AlmCoding/sternenhimmel/arduino/README.md

## Arduino Settings
Board: NodeMCU 1.0 ESP-12E Module

## Libraries
MCP23017 by Bertrand Lemasle Version 1.1.2 (https://github.com/blemasle/arduino-mcp23017)
