AlmCoding/sternenhimmel/raspberry-pi/README.txt

Raspberry Pi Access Point
	SSID: Sternenhimmel
	Passwd: Sternenhimmel-psarte
