AlmCoding/sternenhimmel/arduino/esp32-daisy-chain/README.md

# Install Dependencies

The project uses the following libraries:

- ArduinoJson = 7.4.2
- NimBLE-Arduino = 2.3.6
- NimBLEOta = 0.2.0 (https://github.com/h2zero/NimBLEOta)

NimBLEOta must be downloaded from GitHub and added to the Arduino IDE libraries folder via:  
**Sketch => Include Library => Add .ZIP Library ...**
