AlmCoding/sternenhimmel/eagle/versions/v3_esp82_not_produced.odt

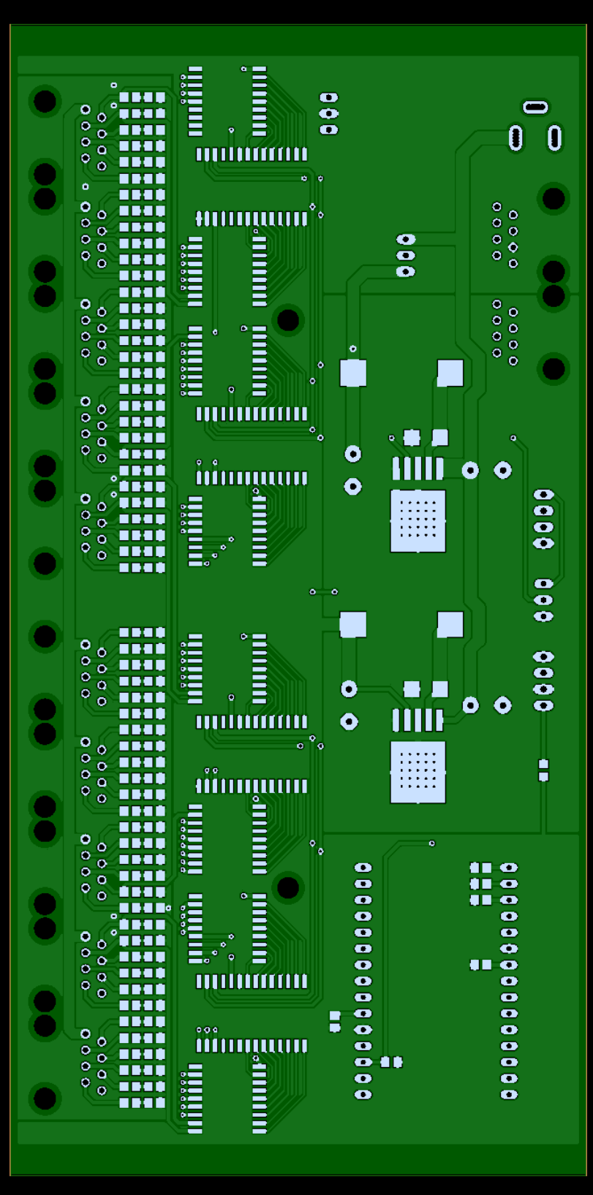
[picture p1: figure]
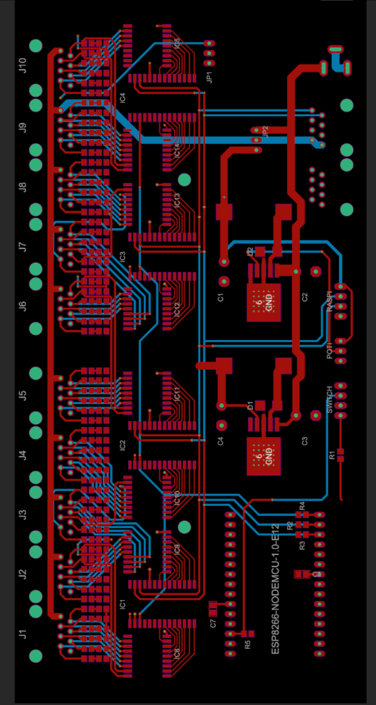
[picture p2: figure]
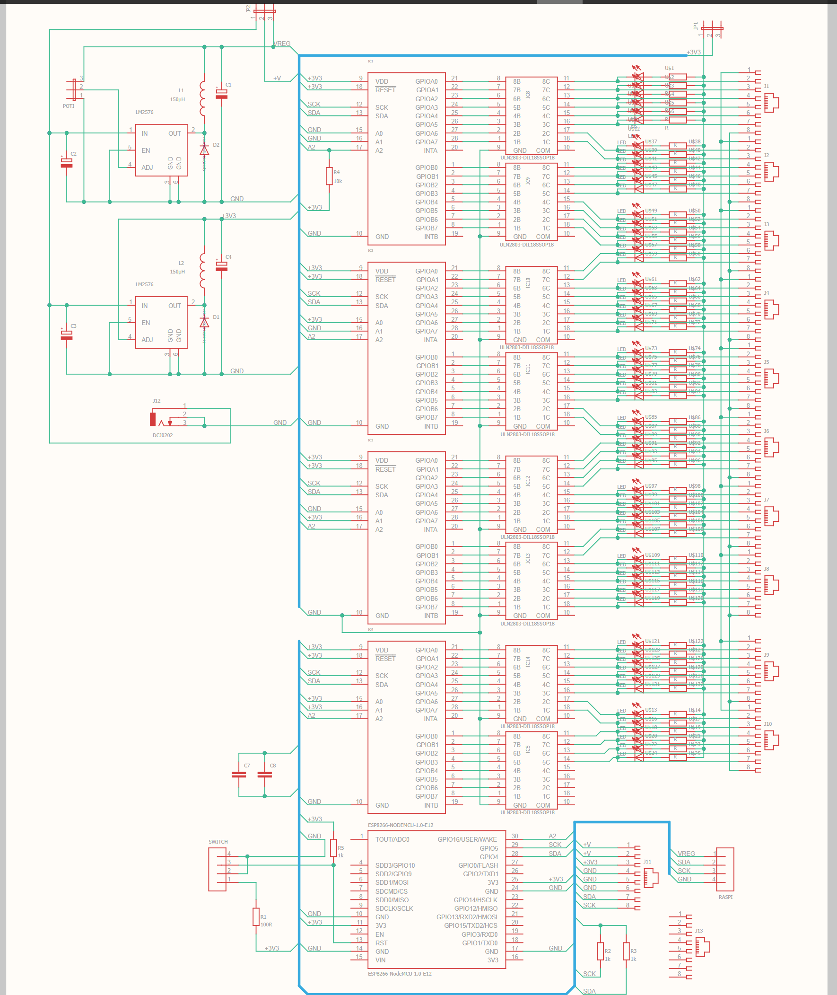
[picture p3: figure]
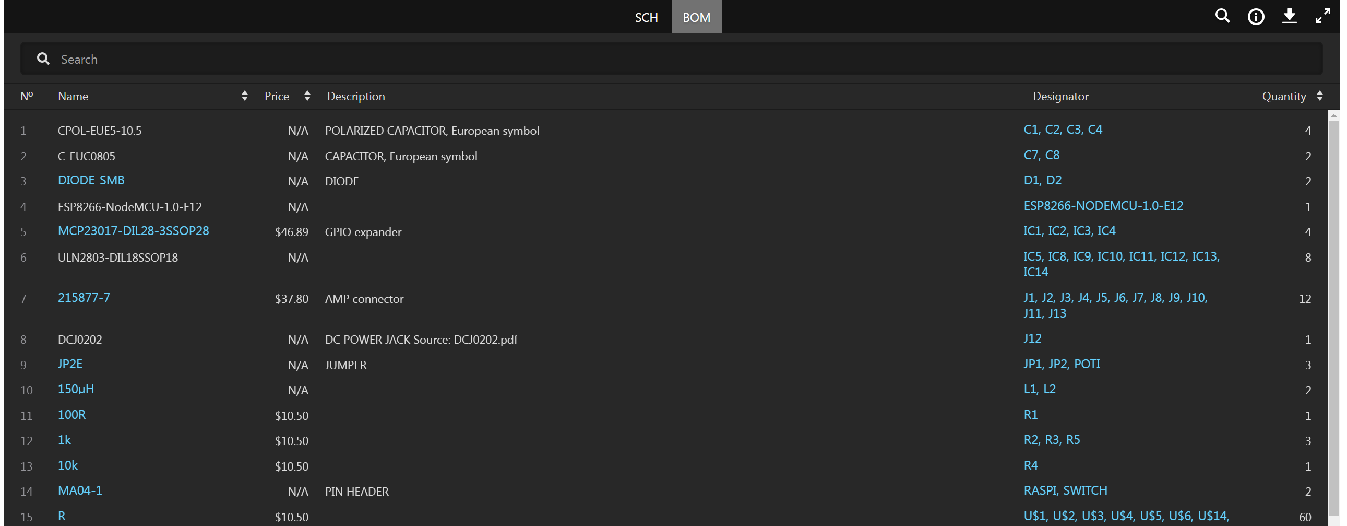
[picture p4: figure]
