AlmCoding/sternenhimmel/kicad/esp32-controller/esp32-controller.ods

Id | Designator | Footprint | Quantity | Designation | Price [€] | Total [€]
1 | C15 | C_0805_2012Metric | 1 | 22uF | 0.20 | 0.20
2 | C7,C8,C1,C9,C2,C17,C16,C3 | C_0805_2012Metric | 8 | 100nF | 0.10 | 0.80
3 | J3,J2,J1,J6,J4,J5 | RJ45_Amphenol_54602-x08_Horizontal | 6 | RJ45 | 0.50 | 3.00
4 | C4,C5,C11,C12,C6,C10 | C_0805_2012Metric | 6 | 4nF | 0.10 | 0.60
5 | U6,U11,U12,U5,U4,U10 | SOT-23-5_HandSoldering | 6 | 74AHC1G08 | 0.15 | 0.90
6 | BOOT1,RESET1 | SW_SPST_Omron_B3FS-100xP | 2 | SW_Omron_B3FS | 0.15 | 0.30
7 | R3 | R_0805_2012Metric | 1 | 330 | 0.10 | 0.10
8 | TP2,TP1 | TestPoint_Pad_D2.0mm | 2 | TestPoint
9 | D1 | LED_0805_2012Metric | 1 | LED | 0.07 | 0.07
10 | U3,U1,U8,U7,U9,U2 | TSSOP-16_4.4x5mm_P0.65mm | 6 | SN65LVDS049 | 1.50 | 9.00
11 | C14 | C_0805_2012Metric | 1 | 10uF | 0.15 | 0.15
12 | U14 | ESP32-S3-WROOM-1 | 1 | ESP32-S3-WROOM-1 | 4.90 | 4.90
13 | R1,R2 | R_0805_2012Metric | 2 | 10k | 0.10 | 0.20
14 | J8 | PinHeader_1x04_P2.54mm_Vertical | 1 | Conn_01x04_Pin | 0.15 | 0.15
15 | TP3 | TestPoint_Pad_D1.5mm | 1 | SCK
16 | TP4 | TestPoint_Pad_D1.5mm | 1 | MOSI
17 | J7 | BarrelJack_Kycon_KLDX-0202-xC_Horizontal | 1 | Barrel_Jack_Switch | 0.45 | 0.45
18 | C13 | C_0805_2012Metric | 1 | 1uF | 0.10 | 0.10
19 | U13 | SOT-223-3_TabPin2 | 1 | AZ1117-3.3 | 0.15 | 0.15
 |  |  |  |  | PCB | 20.00
 |  |  |  |  | SUM (Bauteile+Platine) | 41.07
 |  |  |  |  | “21%” MwSt. | 8.6247
 |  |  |  |  | TOTAL | 49.6947
