AlmCoding/sternenhimmel/kicad/led-driver/led-driver.ods

Id | Designator | Footprint | Quantity | Designation | Price [€] | Total [€]
1 | D3,D11,D5,D2,D13,D8,D1,D7,D4,D9,D10,D6,D12 | LED_0805_2012Metric | 13 | LED | 0.07 | 0.91
2 | C3,C4 | C_0805_2012Metric | 2 | 100nF | 0.08 | 0.16
3 | J2,J1 | RJ45_Amphenol_54602-x08_Horizontal | 2 | RJ45 | 0.50 | 1.00
4 | C5 | C_0805_2012Metric | 1 | 4nF | 0.10 | 0.10
5 | J3 | PinSocket_1x02_P2.54mm_Vertical | 1 | Conn_01x02_Pin | 0.10 | 0.10
6 | J11,J5,J7,J6,J4,J8,J10,J9 | PinHeader_2x06_P2.54mm_Vertical | 8 | Conn_02x06_Odd_Even | 0.15 | 1.20
7 | R1,R2 | R_0805_2012Metric | 2 | 100 | 0.10 | 0.20
8 | C1 | C_0805_2012Metric | 1 | 1uF | 0.10 | 0.10
9 | C2 | C_0805_2012Metric | 1 | 10uF | 0.15 | 0.15
10 | R3 | R_0805_2012Metric | 1 | 2k4 | 0.10 | 0.10
11 | U1 | SOT-23-5 | 1 | LP2985-33DBVR | 0.25 | 0.25
12 | U3 | HTSSOP-20-1EP_4.4x6.5mm_P0.65mm_EP3.4x6.5mm_Mask2.75x3.43mm_ThermalVias | 1 | TLC5971PWP | 1.90 | 1.90
13 | U2 | TSSOP-16_4.4x5mm_P0.65mm | 1 | SN65LVDS049 | 1.50 | 1.50
14 | R5 | R_0805_2012Metric | 1 | 2k | 0.10 | 0.10
15 | R4 | R_0805_2012Metric | 1 | 0
 |  |  |  |  |  |  | 4.50 | https://be.eurocircuits.com/
 |  |  |  |  | PCB | 3.00 | 2.00 | https://portal.multi-circuit-boards.eu/
 |  |  |  |  | SUM (Bauteile+Platine) | 10.77
 |  |  |  |  | “21%” MwSt. | 2.2617
 |  |  |  | 60 | Pieces | 646.20
 |  |  |  |  | “21%” | 135.702
 |  |  |  |  | TOTAL | 781.90
 |  |  |  | *Bauteilpreise beinhalten Rabatte von Bestellmengen für ~2 Sternenhimmel
