AlmCoding/sternenhimmel/eagle/versions/v2_esp82.pdf

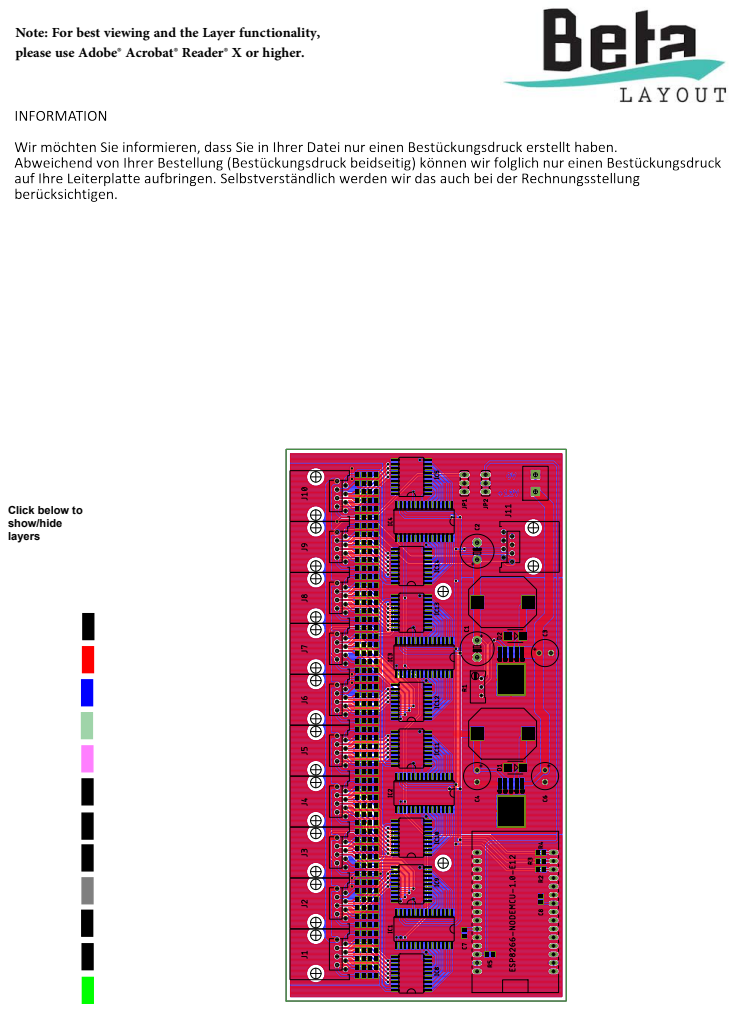
[picture p5: page 1]

Note: For best viewing and the Layer functionality,
please use Adobe® Acrobat® Reader® X or higher.
