AlmCoding/sternenhimmel/eagle/versions/v1_esp82.pdf

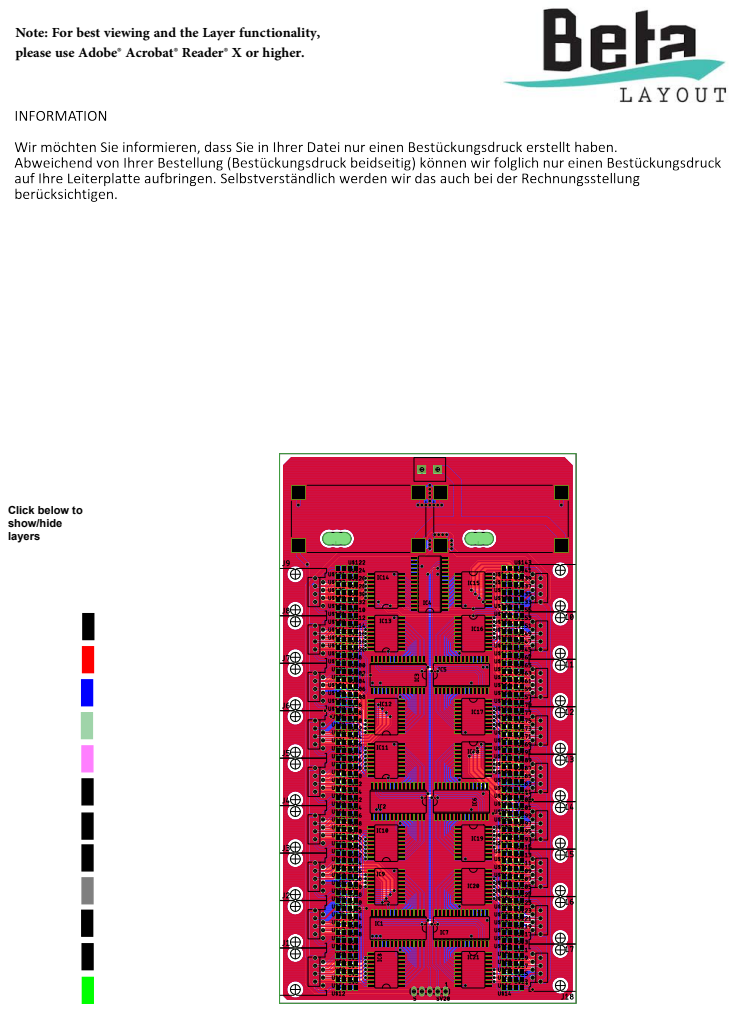
[picture p6: page 1]

Note: For best viewing and the Layer functionality,
please use Adobe® Acrobat® Reader® X or higher.
