AlmCoding/sternenhimmel/kicad/led-driver/led-driver.kicad_pcb

## KiCad design kicad/led-driver/led-driver.kicad_pcb (2025-09-02)

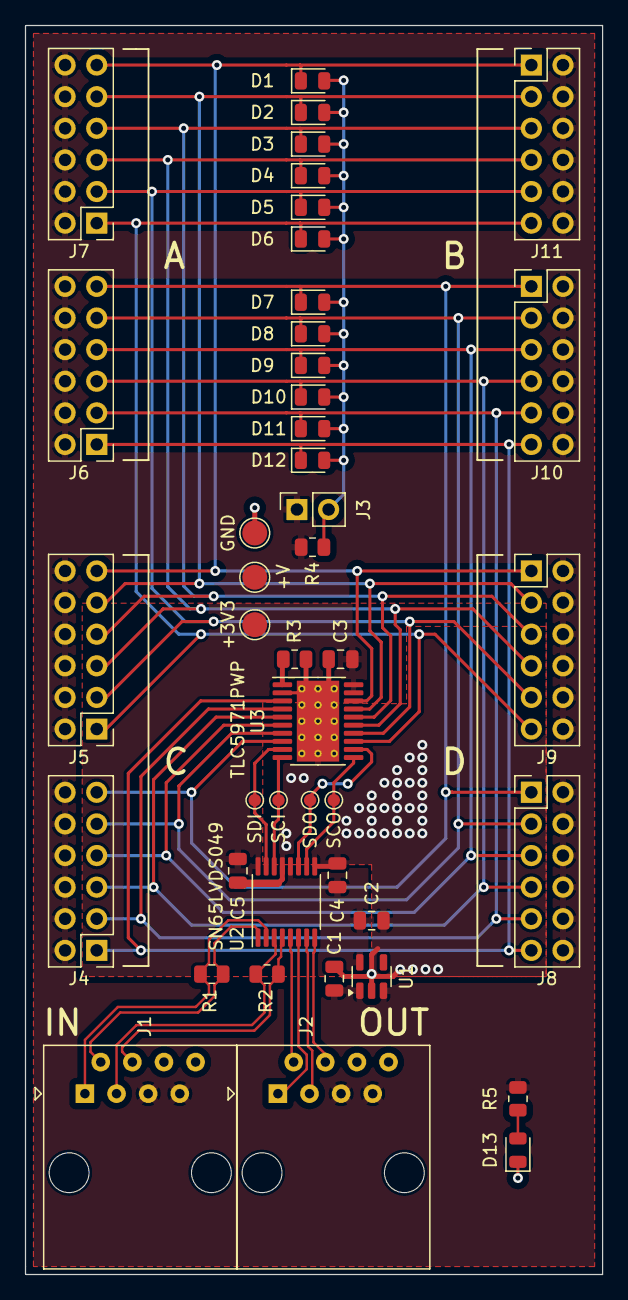
[picture p7: board led-driver.kicad_pcb from above]

Board: 2 copper layers, 46.4 x 100.3 mm, 44 parts (0 on the bottom side), 30 nets.

Parts:
+3V3: TestPoint_Pad_D2.0mm
+V: TestPoint_Pad_D2.0mm
C1: 1uF; C_0805_2012Metric
C2: 10uF; C_0805_2012Metric
C3, C4: 100nF; C_0805_2012Metric
C5: 4nF; C_0805_2012Metric
D1, D2, D3, D4, D5, D6, D7, D8, D9, D10, D11, D12, D13: LED; LED_0805_2012Metric
GND: TestPoint_Pad_D2.0mm
J1, J2: RJ45; RJ45_Amphenol_54602-x08_Horizontal
J3: Conn_01x02_Pin; PinSocket_1x02_P2.54mm_Vertical
J4, J5, J6, J7, J8, J9, J10, J11: Conn_02x06_Odd_Even; PinHeader_2x06_P2.54mm_Vertical
R1, R2: 100; R_0805_2012Metric
R3: 2k4; R_0805_2012Metric
R4: 0; R_0805_2012Metric
R5: 2k; R_0805_2012Metric
SCI: TestPoint_Pad_D1.0mm
SCO: TestPoint_Pad_D1.0mm
SDI: TestPoint_Pad_D1.0mm
SDO: TestPoint_Pad_D1.0mm
U1: LP2985-33DBVR; SOT-23-5
U2: SN65LVDS049; TSSOP-16_4.4x5mm_P0.65mm
U3: TLC5971PWP; HTSSOP-20-1EP_4.4x6.5mm_P0.65mm_EP3.4x6.5mm_Mask2.75x3.43mm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

Connections:
+3V3: +3V3.1, C2.1, C3.1, C4.1, C5.1, U1.5 (VOUT), U2.12 (VCC), U2.16 (EN), U3.19 (VCC), U3.20 (VREG)
+12V: +V.1, C1.1, J1.5, J1.7, J2.5, J2.7, J3.1, J4.2, J4.4, J4.6, J4.8, J4.10, J4.12, J5.2, J5.4, J5.6, J5.8, J5.10, J5.12, J6.2, J6.4, J6.6, J6.8, J6.10, J6.12, J7.2, J7.4, J7.6, J7.8, J7.10, J7.12, J8.2, J8.4, J8.6, J8.8, J8.10, J8.12, J9.2, J9.4, J9.6, J9.8, J9.10, J9.12, J10.2, J10.4, J10.6, J10.8, J10.10, J10.12, J11.2, J11.4, J11.6, J11.8, J11.10, J11.12, R4.2, R5.1, U1.1 (VIN), U1.3 (EN)
/Cin_N: J1.3, R2.2, U2.3 (RIN2-)
/Cin_P: J1.4, R2.1, U2.4 (RIN2+)
/Cout_N: J2.3, U2.7 (DOUT1-)
/Cout_P: J2.4, U2.8 (DOUT1+)
/Din_N: J1.2, R1.2, U2.1 (RIN1-)
/Din_P: J1.1, R1.1, U2.2 (RIN1+)
/Dout_N: J2.2, U2.5 (DOUT2-)
/Dout_P: J2.1, U2.6 (DOUT2+)
GND: C1.2, C2.2, C3.2, C4.2, C5.2, D13.1 (K), GND.1, J1.6, J1.8, J2.6, J2.8, R3.2, U1.2 (GND), U2.9 (~EN), U2.13 (GND), U3.2 (GND), U3.21 (GND)
unnamed: D1.2 (A), D2.2 (A), D3.2 (A), D4.2 (A), D5.2 (A), D6.2 (A), D7.2 (A), D8.2 (A), D9.2 (A), D10.2 (A), D11.2 (A), D12.2 (A), J3.2, R4.1
unnamed: D1.1 (K), J5.11, J7.11, J9.1, J11.1, U3.18 (OUTB3)
unnamed: D2.1 (K), J5.9, J7.9, J9.3, J11.3, U3.17 (OUTG3)
unnamed: D3.1 (K), J5.7, J7.7, J9.5, J11.5, U3.16 (OUTR3)
unnamed: D4.1 (K), J5.5, J7.5, J9.7, J11.7, U3.15 (OUTB2)
unnamed: D5.1 (K), J5.3, J7.3, J9.9, J11.9, U3.14 (OUTG2)
unnamed: D6.1 (K), J5.1, J7.1, J9.11, J11.11, U3.13 (OUTR2)
unnamed: D7.1 (K), J4.11, J6.11, J8.1, J10.1, U3.8 (OUTB1)
unnamed: D8.1 (K), J4.9, J6.9, J8.3, J10.3, U3.7 (OUTG1)
unnamed: D9.1 (K), J4.7, J6.7, J8.5, J10.5, U3.6 (OUTR1)
unnamed: D10.1 (K), J4.5, J6.5, J8.7, J10.7, U3.5 (OUTB0)
unnamed: D11.1 (K), J4.3, J6.3, J8.9, J10.9, U3.4 (OUTG0)
unnamed: D12.1 (K), J4.1, J6.1, J8.11, J10.11, U3.3 (OUTR0)
unnamed: D13.2 (A), R5.2
unnamed: SCO.1, U2.10 (DIN1), U3.11 (SCKO)
unnamed: SDO.1, U2.11 (DIN2), U3.12 (SDTO)
unnamed: SDI.1, U2.15 (ROUT1), U3.9 (SDTI)
unnamed: SCI.1, U2.14 (ROUT2), U3.10 (SCKI)
unnamed: R3.1, U3.1 (IREF)
