AlmCoding/sternenhimmel/kicad/esp32-controller/esp32-controller.kicad_pcb

## KiCad design kicad/esp32-controller/esp32-controller.kicad_pcb (2025-08-04)

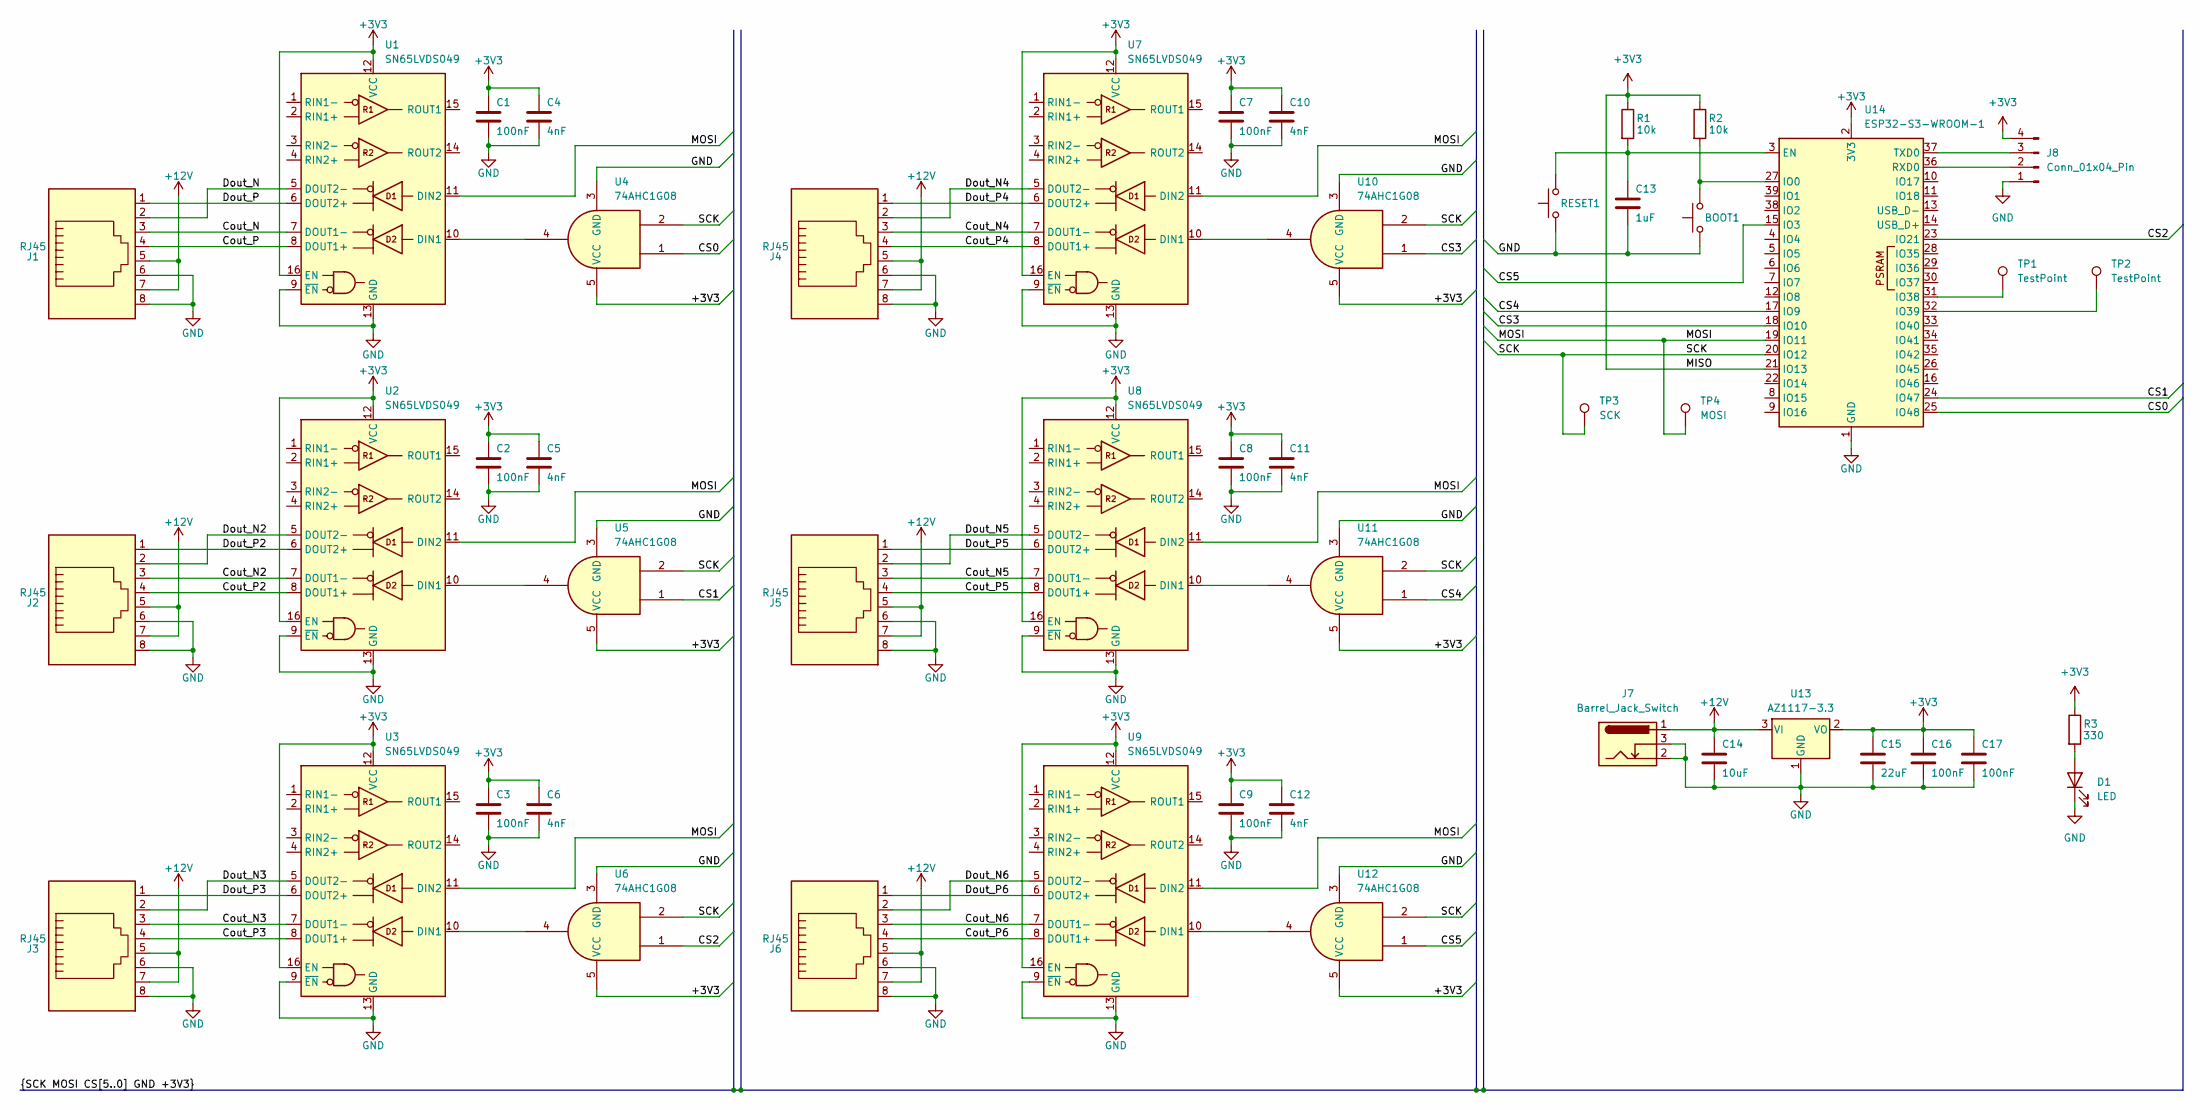
[picture p8: schematic esp32-controller.kicad_sch]

Parts:
BOOT1: SW_Omron_B3FS; SW_SPST_Omron_B3FS-100xP
C1, C2, C3, C7, C8, C9, C16, C17: 100nF; C_0805_2012Metric
C4, C5, C6, C10, C11, C12: 4nF; C_0805_2012Metric
C13: 1uF; C_0805_2012Metric
C14: 10uF; C_0805_2012Metric
C15: 22uF; C_0805_2012Metric
D1: LED; LED_0805_2012Metric
J1, J2, J3, J4, J5, J6: RJ45; RJ45_Amphenol_54602-x08_Horizontal
J7: Barrel_Jack_Switch; BarrelJack_Kycon_KLDX-0202-xC_Horizontal
J8: Conn_01x04_Pin; PinHeader_1x04_P2.54mm_Vertical
R1, R2: 10k; R_0805_2012Metric
R3: 330; R_0805_2012Metric
RESET1: SW_Omron_B3FS; SW_SPST_Omron_B3FS-100xP
TP1, TP2: TestPoint; TestPoint_Pad_D2.0mm
TP3: SCK; TestPoint_Pad_D1.5mm
TP4: MOSI; TestPoint_Pad_D1.5mm
U1, U2, U3, U7, U8, U9: SN65LVDS049; TSSOP-16_4.4x5mm_P0.65mm
U4, U5, U6, U10, U11, U12: 74AHC1G08; SOT-23-5_HandSoldering
U13: AZ1117-3.3; SOT-223-3_TabPin2
U14: ESP32-S3-WROOM-1

Connections:
+3V3: C1.1, C2.1, C3.1, C4.1, C5.1, C6.1, C7.1, C8.1, C9.1, C10.1, C11.1, C12.1, C15.1, C16.1, C17.1, J8.4, R1.1, R2.1, R3.1, U1.12 (VCC), U1.16 (EN), U2.12 (VCC), U2.16 (EN), U3.12 (VCC), U3.16 (EN), U4.5 (VCC), U5.5 (VCC), U6.5 (VCC), U7.12 (VCC), U7.16 (EN), U8.12 (VCC), U8.16 (EN), U9.12 (VCC), U9.16 (EN), U10.5 (VCC), U11.5 (VCC), U12.5 (VCC), U13.2 (VO), U14.2 (3V3), U14.21 (IO13); also elsewhere on the board
+12V: C14.1, J1.5, J1.7, J2.5, J2.7, J3.5, J3.7, J4.5, J4.7, J5.5, J5.7, J6.5, J6.7, J7.1, U13.3 (VI); also elsewhere on the board
/CS0: U4.1, U14.25 (IO48)
/CS1: U5.1, U14.24 (IO47)
/CS2: U6.1, U14.23 (IO21)
/CS3: U10.1, U14.18 (IO10)
/CS4: U11.1, U14.17 (IO9)
/CS5: U12.1, U14.15 (IO3)
/Cout_N: J1.3, U1.7 (DOUT1-)
/Cout_N2: J2.3, U2.7 (DOUT1-)
/Cout_N3: J3.3, U3.7 (DOUT1-)
/Cout_N4: J4.3, U7.7 (DOUT1-)
/Cout_N5: J5.3, U8.7 (DOUT1-)
/Cout_N6: J6.3, U9.7 (DOUT1-)
/Cout_P: J1.4, U1.8 (DOUT1+)
/Cout_P2: J2.4, U2.8 (DOUT1+)
/Cout_P3: J3.4, U3.8 (DOUT1+)
/Cout_P4: J4.4, U7.8 (DOUT1+)
/Cout_P5: J5.4, U8.8 (DOUT1+)
/Cout_P6: J6.4, U9.8 (DOUT1+)
/Dout_N: J1.2, U1.5 (DOUT2-)
/Dout_N2: J2.2, U2.5 (DOUT2-)
/Dout_N3: J3.2, U3.5 (DOUT2-)
/Dout_N4: J4.2, U7.5 (DOUT2-)
/Dout_N5: J5.2, U8.5 (DOUT2-)
/Dout_N6: J6.2, U9.5 (DOUT2-)
/Dout_P: J1.1, U1.6 (DOUT2+)
/Dout_P2: J2.1, U2.6 (DOUT2+)
/Dout_P3: J3.1, U3.6 (DOUT2+)
/Dout_P4: J4.1, U7.6 (DOUT2+)
/Dout_P5: J5.1, U8.6 (DOUT2+)
/Dout_P6: J6.1, U9.6 (DOUT2+)
/MOSI: TP4.1, U1.11 (DIN2), U2.11 (DIN2), U3.11 (DIN2), U7.11 (DIN2), U8.11 (DIN2), U9.11 (DIN2), U14.19 (IO11)
/SCK: TP3.1, U4.2, U5.2, U6.2, U10.2, U11.2, U12.2, U14.20 (IO12)
GND: BOOT1.1, C1.2, C2.2, C3.2, C4.2, C5.2, C6.2, C7.2, C8.2, C9.2, C10.2, C11.2, C12.2, C13.2, C14.2, C15.2, C16.2, C17.2, D1.1 (K), J1.6, J1.8, J2.6, J2.8, J3.6, J3.8, J4.6, J4.8, J5.6, J5.8, J6.6, J6.8, J7.2, J7.3, J8.1, RESET1.1, U1.9 (~EN), U1.13 (GND), U2.9 (~EN), U2.13 (GND), U3.9 (~EN), U3.13 (GND), U4.3 (GND), U5.3 (GND), U6.3 (GND), U7.9 (~EN), U7.13 (GND), U8.9 (~EN), U8.13 (GND), U9.9 (~EN), U9.13 (GND), U10.3 (GND), U11.3 (GND), U12.3 (GND), U13.1 (GND), U14.1 (GND), U14.40 (GND), U14.41 (GND); also elsewhere on the board
unnamed: D1.2 (A), R3.2
unnamed: J8.2, U14.36 (RXD0)
unnamed: J8.3, U14.37 (TXD0)
unnamed: U1.10 (DIN1), U4.4
unnamed: U2.10 (DIN1), U5.4
unnamed: U3.10 (DIN1), U6.4
unnamed: U7.10 (DIN1), U10.4
unnamed: U8.10 (DIN1), U11.4
unnamed: U9.10 (DIN1), U12.4
unnamed: C13.1, R1.2, RESET1.2, U14.3 (EN)
unnamed: BOOT1.2, R2.2, U14.27 (IO0)
unnamed: TP1.1, U14.31 (IO38)
unnamed: TP2.1, U14.32 (IO39)

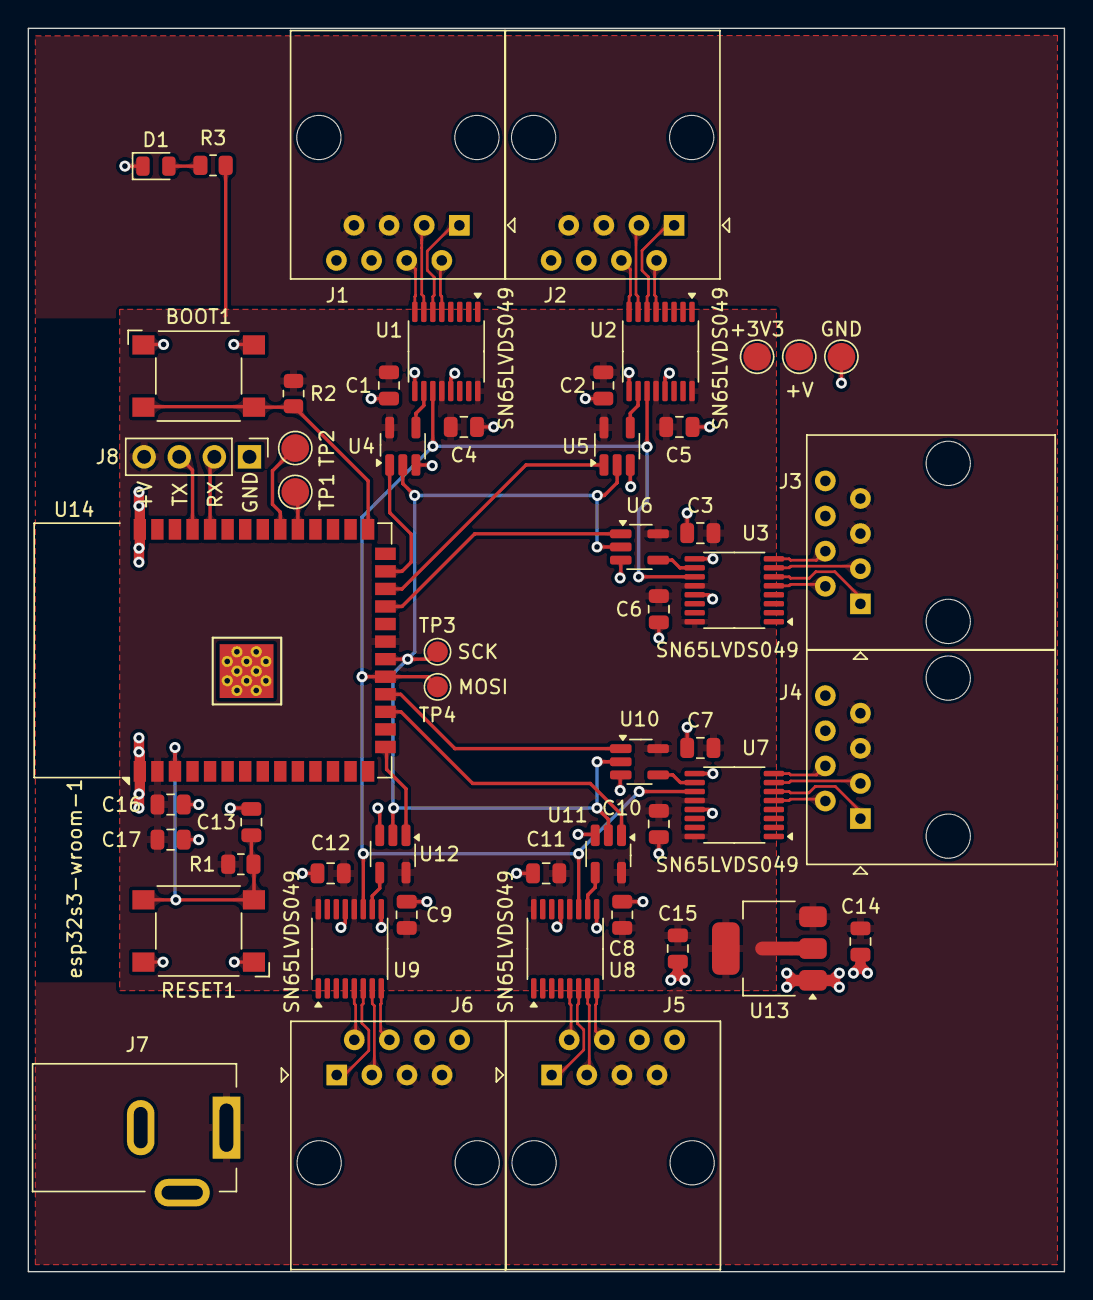
[picture p9: board esp32-controller.kicad_pcb from above]

Board: 2 copper layers, 74.9 x 89.9 mm, 52 parts (0 on the bottom side), 48 nets.

Other parts of the board:
+3V3: TestPoint_Pad_D2.0mm
+V: TestPoint_Pad_D2.0mm
GND: TestPoint_Pad_D2.0mm

Their connections:
+3V3: +3V3.1; also elsewhere on the board
+12V: +V.1; also elsewhere on the board
GND: GND.1; also elsewhere on the board
