AlmCoding/sternenhimmel/raspberry-pi/show2output.py

mapping = {
    3: [3, 4],
    11: [11, 6],
    23: [23, 24],
    29: [29, 46],
    32: [32, 34],
    35: [35, 102],
    43: [43, 28, 44],
    44: [44, 43, 45],
    49: [49, 66],
    50: [50, 51, 65],
    59: [59, 87],
    65: [65, 66],
    67: [67, 50, 51, 65],
    70: [70, 72],
    76: [76, 75, 78],
    79: [79, 80],
    81: [81, 82],
    88: [88, 89, 91],
    95: [95, 96],
    105: [105, 106]
}
