AlmCoding/sternenhimmel/(commit log)

2019-11-03 connector shift
2019-11-24 add layout
    [GPIOexpander.brd, GPIOexpander.sch]
2019-11-24 clean up
    [GPIOexpander.brd, GPIOexpander.sch]
2023-04-23 Fix out2mcp pin
2023-04-23 Fix debug switch
2024-05-05 Add things
    [test.kicad_pcb, test.kicad_sch]
2024-12-30 Save progress
    [GPIOexpander.drl, test-B_Cu.gbr, test-B_Mask.gbr, test-B_Paste.gbr, test-B_Silkscreen.gbr, test-Edge_Cuts.gbr, test-F_Cu.gbr, test-F_Mask.gbr]
2024-12-30 Add esp32 expander
2024-12-31 port to esp32
2025-01-02 Fix led driver vcc
    [test-B_Cu.gbr, test-B_Mask.gbr, test-B_Paste.gbr, test-B_Silkscreen.gbr, test-Edge_Cuts.gbr, test-F_Cu.gbr, test-F_Mask.gbr, test-F_Paste.gbr]
2025-01-02 fix vreg on led driver
    [test.kicad_pcb, test.kicad_sch]
2025-01-13 Add sketch for daisy chain
2025-01-13 Add calibration values
2025-01-16 Enable tear drops on PCB
    [test.kicad_pcb]
2025-01-16 Add power test points
    [test.kicad_pcb]
2025-01-23 Update PCBs
    [esp32-controller.kicad_pcb, esp32-controller.kicad_sch, led-driver.kicad_pcb, led-driver.kicad_sch]
2025-01-24 Complete controller PCB v1
    [esp32-controller.kicad_pcb, esp32-controller.kicad_sch]
2025-02-02 Improve thermal props
    [led-driver.kicad_pcb]
2025-02-03 Thermal refactoring
    [led-driver.kicad_pcb]
2025-02-06 Migrate to 3 chain setup
    [esp32-controller.kicad_pcb, esp32-controller.kicad_sch, led-driver.kicad_pcb]
2025-02-08 Move to 3 chain setup
    [esp32-controller.kicad_sch]
2025-03-05 Complete controller pcb
    [esp32-controller.kicad_pcb, esp32-controller.kicad_sch]
2025-07-18 Refactor controller pcb
    [esp32-controller.kicad_pcb, esp32-controller.kicad_sch]
2025-08-02 Fix pcb + software
    [esp32-controller.kicad_pcb, esp32-controller.kicad_sch]
2025-08-04 Add testpoints to pcbs
    [esp32-controller.kicad_pcb, esp32-controller.kicad_sch, led-driver.kicad_pcb, led-driver.kicad_sch]
2025-08-19 Add default values + refactoring
    [esp32-controller.csv, esp32-controller.ods, led-driver.csv, led-driver.ods]
2025-08-26 Add led changed filter on upload
2025-08-27 Add play show to esp32 + fix python shallow copy bug
    [Controller.cpp, Controller.h]
2025-08-28 Fix led enumeration
    [led-driver.kicad_pcb, led-driver.kicad_sch]
2025-08-29 Fix esp32 ble rx timeout bug
    [BleManager.cpp, BleManager.h, Controller.cpp, Controller.h, DaisyChain.cpp, Player.cpp, common.cpp]
2025-08-29 Add chain statistics calculation
2025-08-30 Update led linearization gamma
2025-09-02 Release LEDpcb V0.1 and ESPpcb V0.1
    [esp32-controller.ods, led-driver.csv, led-driver.kicad_pcb, led-driver.ods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]
2025-09-07 Run periodic chain refresh
2025-09-07 DaisyChain Release V0.0.5
    Add periodic chain refresh
